bruno-zahirovic/Self-Balancing-Robot/Media/1663781147604.jpg

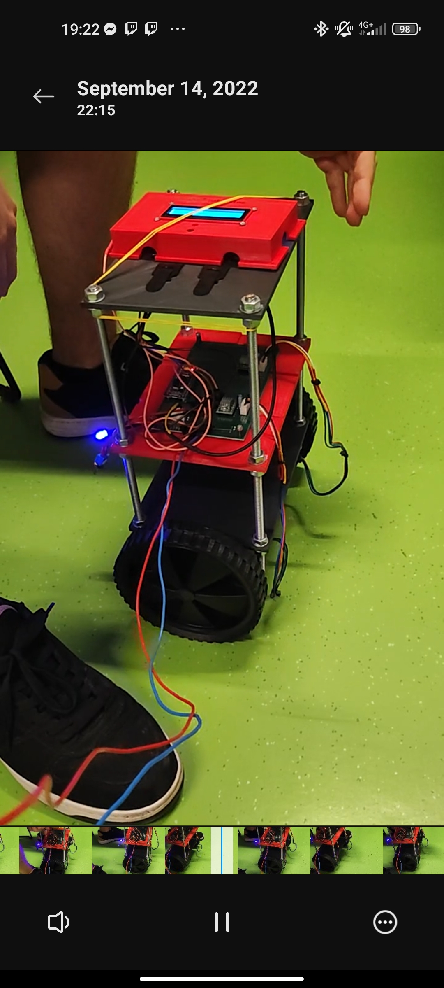
Media/1663781147604.jpg
