bruno-zahirovic/Self-Balancing-Robot/Changelog.md

### Development
- Created Initial Project Structure
- Updated README file with basic project info
- Added Changelog file
- Add .gitignore file
- Add Diagrams and Schematics
- Add Media folder with Commercial video, the paper and pictures

### Start of project - Add Changes above this line ---------------------
