bruno-zahirovic/Self-Balancing-Robot/(commit log)

2022-09-20 Add Electircal Schematics
2022-09-21 Add gitignore file. Add basic program flow diagram.
2022-09-21 Add full program flow diagram
2022-09-21 Update Changelog. Finalize Diagrams&Schematics.
2022-09-21 Add Finalized project version
    [BluePillSelfBalancingRobot Debug.cfg]
